mcristaldo17/Single-Axis-Rate-Table/README.md

# Single-Axis Rate Table
## Cloned repository on 03/15/2025
Design and development of a single-axis rate table project for nanosatellites at the "Agencia Espacial del Paraguay" (Paraguay Space Agency).
"Rate Table Codes" includes the codes for the Arduino microcontroller and the codes for the User Interface.
"Anexxes" include detailed documentation.
