mcristaldo17/Single-Axis-Rate-Table/Rate Table Design/Assembly_RateTable.SLDASM

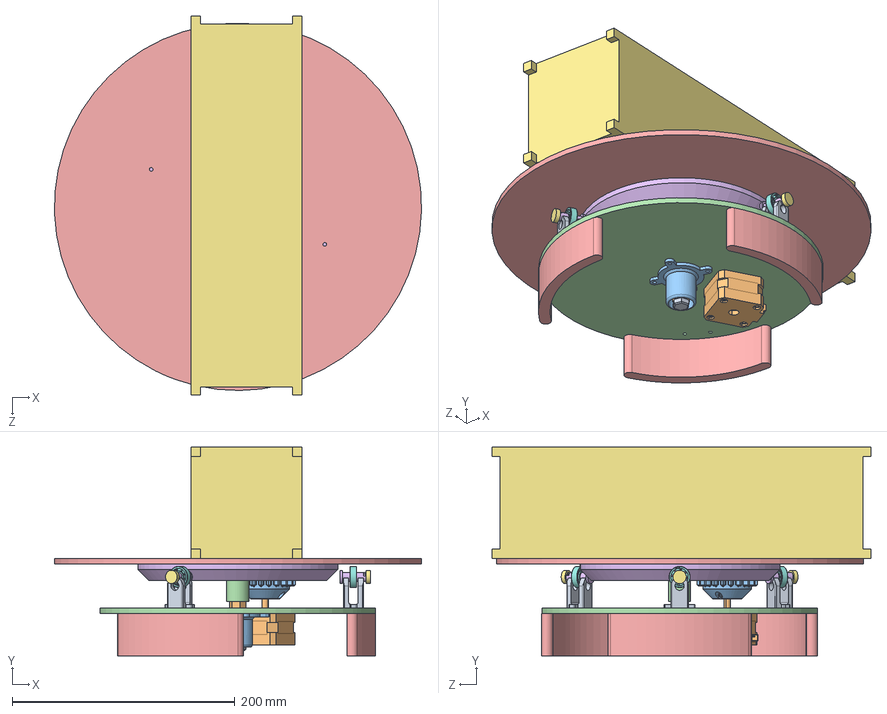
[picture p28: CAD file, 2023-11-02, last stored version]
Rate Table Design/Assembly_RateTable.SLDASM
329.8 x 187.8 x 340.5 mm
Stepper motor Nema 17 (17HS2408).step
Gear_Nema17
Bearing_Support x 3
LaserCut_1
Soportes3D x 3
Pin x 3
Close_Pin x 3
BALL BEARING 607 7x19x6 x 5
M8_Tornillo
M8_Tuerca x 4
Soporte_Central
Centralizador v1
LaserCut_3
External_Gear
