mcristaldo17/Single-Axis-Rate-Table/Rate Table Design/Assembly_Central.SLDASM

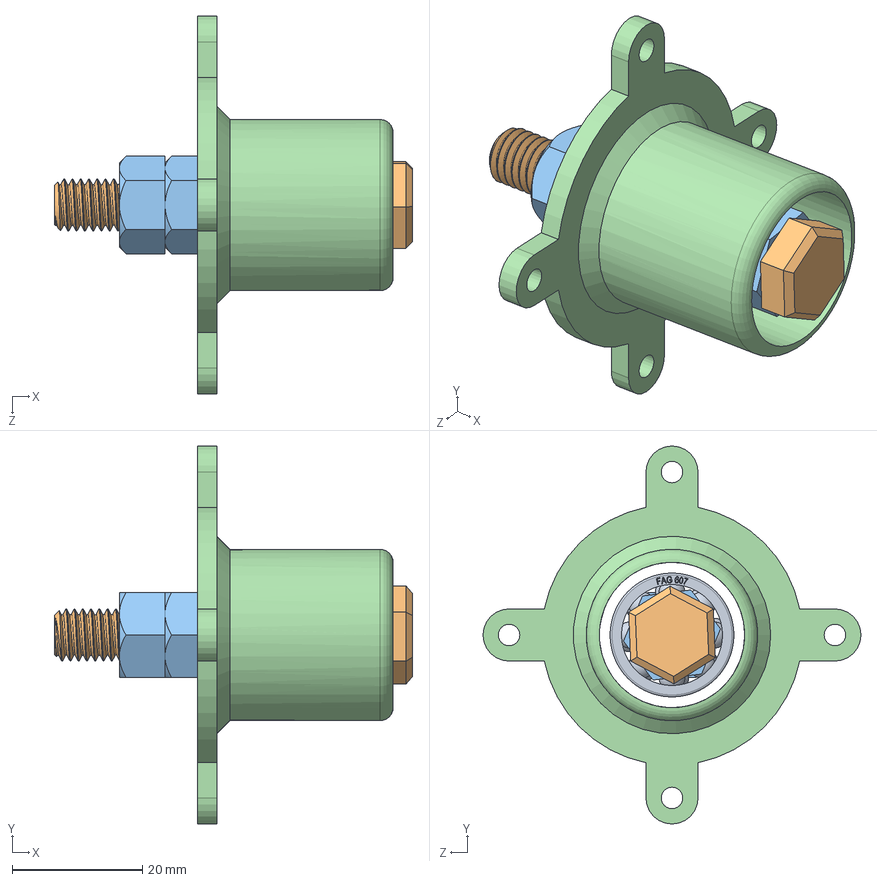
[picture p29: CAD file, 2023-11-02, last stored version]
Rate Table Design/Assembly_Central.SLDASM
55.0 x 58.0 x 58.0 mm
BALL BEARING 607 7x19x6 x 2
M8_Tornillo
M8_Tuerca x 4
Soporte_Central
