mcristaldo17/Single-Axis-Rate-Table/Rate Table Design/Corte Láser/LaserCut_3.SLDPRT

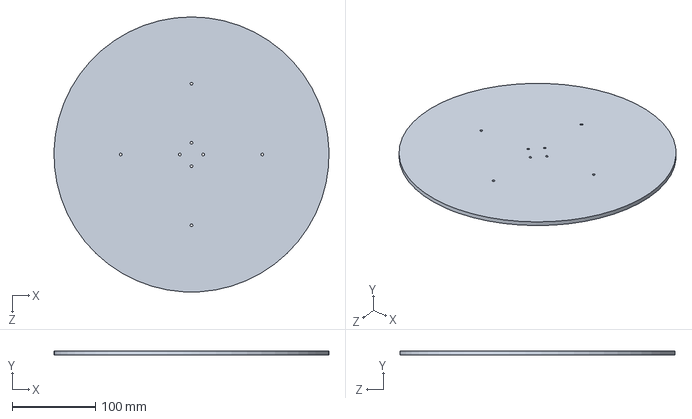
[picture p30: CAD file, 2023-11-02, last stored version]
Rate Table Design/Corte Láser/LaserCut_3.SLDPRT
329.9 x 5.00 x 330.0 mm
