mcristaldo17/Single-Axis-Rate-Table/Rate Table Design/Impresión 3D/Soporte_Central.SLDPRT

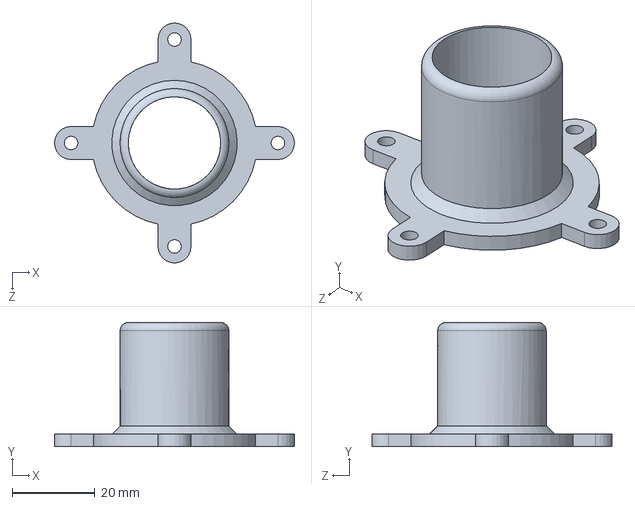
[picture p31: CAD file, 2023-11-02, last stored version]
Rate Table Design/Impresión 3D/Soporte_Central.SLDPRT
58.0 x 30.0 x 58.0 mm
