mcristaldo17/Single-Axis-Rate-Table/Rate Table Design/3U_CubeSat_Dimensions.SLDPRT

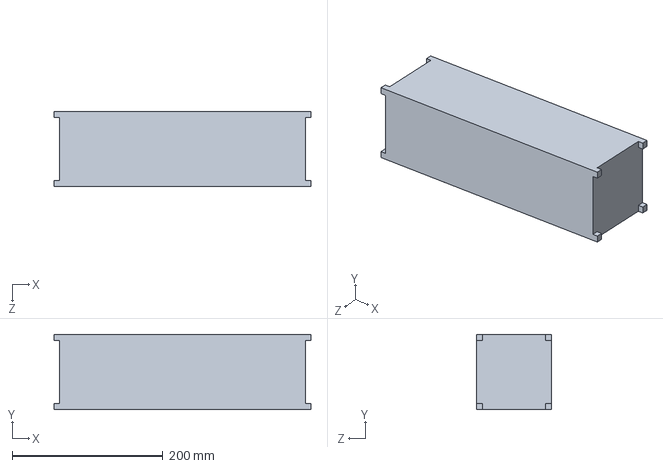
[picture p32: CAD file, 2023-11-02, last stored version]
Rate Table Design/3U_CubeSat_Dimensions.SLDPRT
340.5 x 100.0 x 100.0 mm
