mcristaldo17/Single-Axis-Rate-Table/Rate Table Design/Corte Láser/LaserCut_1.SLDPRT

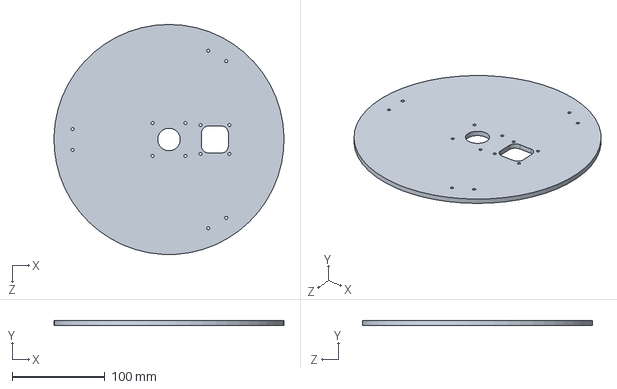
[picture p33: CAD file, 2023-11-02, last stored version]
Rate Table Design/Corte Láser/LaserCut_1.SLDPRT
247.9 x 5.00 x 248.0 mm
