mcristaldo17/Single-Axis-Rate-Table/Rate Table Design/Impresión 3D/Gear_Nema17.SLDPRT

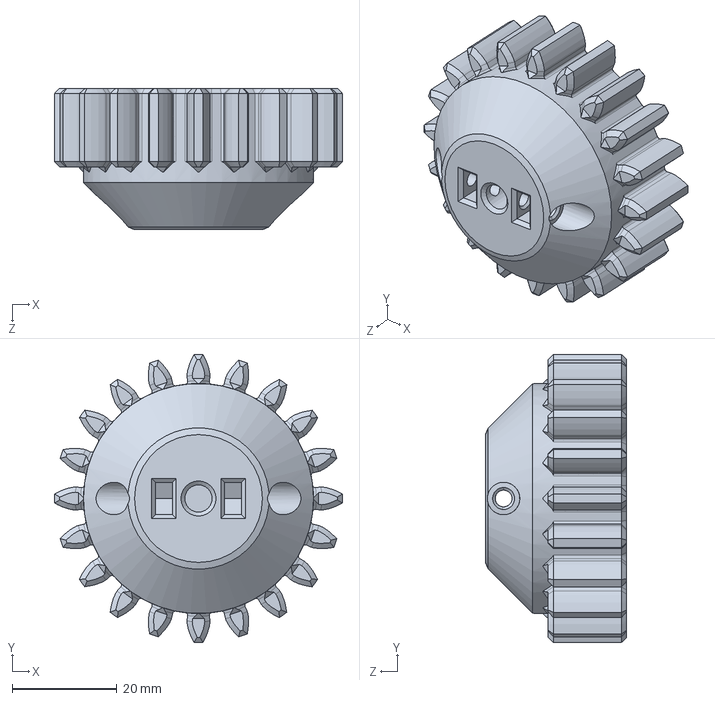
[picture p34: CAD file, 2023-11-02, last stored version]
Rate Table Design/Impresión 3D/Gear_Nema17.SLDPRT
55.0 x 55.0 x 27.0 mm
