mcristaldo17/Single-Axis-Rate-Table/Rate Table Design/Impresión 3D/Soportes3D.SLDPRT

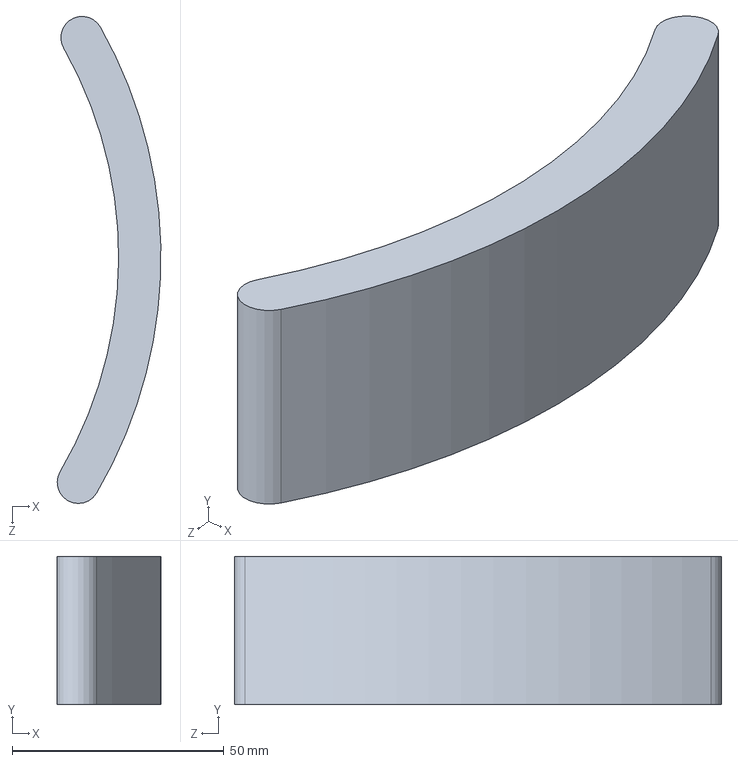
[picture p35: CAD file, 2023-11-02, last stored version]
Rate Table Design/Impresión 3D/Soportes3D.SLDPRT
24.5 x 35.0 x 115.0 mm
