mcristaldo17/Single-Axis-Rate-Table/Rate Table Design/Stepper motor Nema 17 (17HS2408).step.SLDPRT

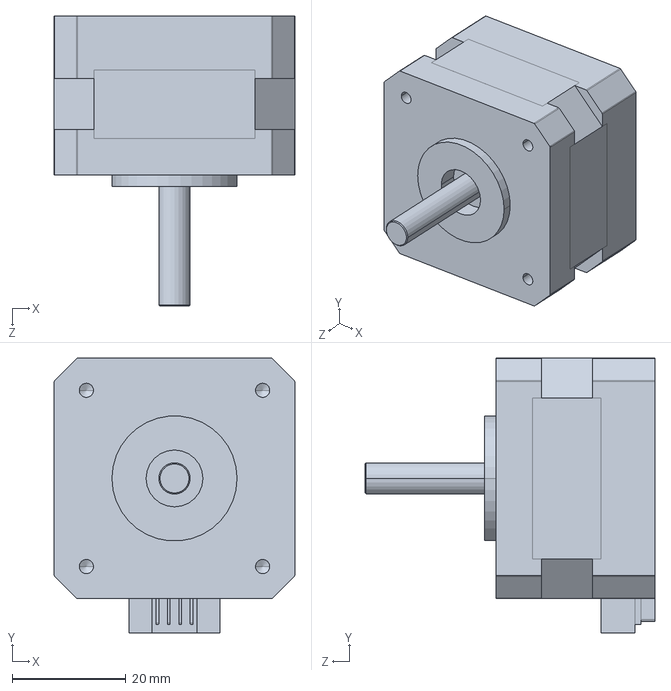
[picture p36: CAD file, 2023-11-02, last stored version]
Rate Table Design/Stepper motor Nema 17 (17HS2408).step.SLDPRT
42.3 x 48.3 x 51.0 mm
