mcristaldo17/Single-Axis-Rate-Table/Rate Table Design/Impresión 3D/Close_Pin.SLDPRT

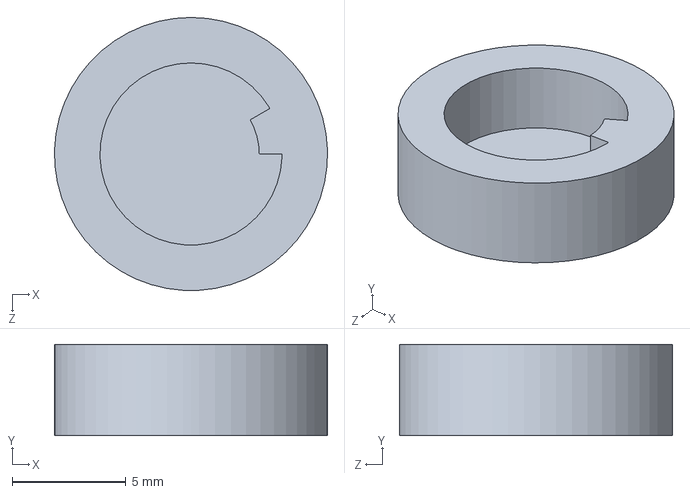
[picture p37: CAD file, 2023-11-02, last stored version]
Rate Table Design/Impresión 3D/Close_Pin.SLDPRT
12.0 x 4.00 x 12.0 mm
