mcristaldo17/Single-Axis-Rate-Table/Rate Table Design/BALL BEARING 607  7x19x6.SLDPRT

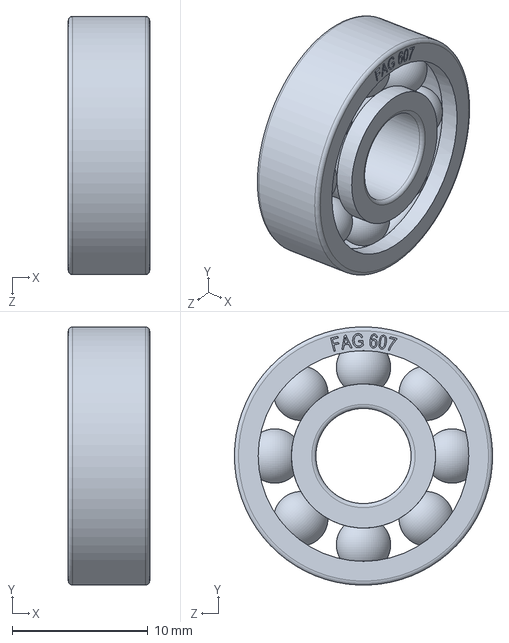
[picture p38: CAD file, 2023-11-02, last stored version]
Rate Table Design/BALL BEARING 607 7x19x6.SLDPRT
6.00 x 19.0 x 19.0 mm
