mcristaldo17/Single-Axis-Rate-Table/Rate Table Design/Impresión 3D/Bearing_Support.SLDPRT

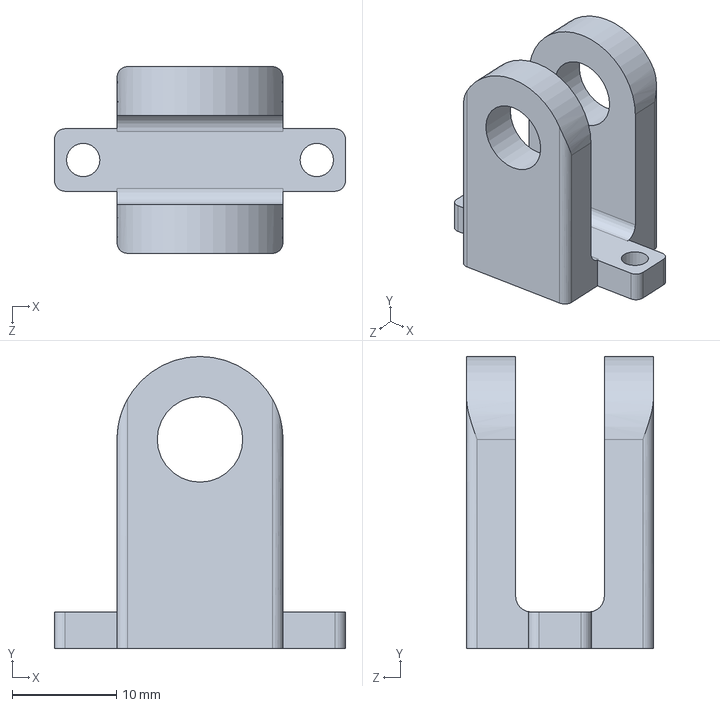
[picture p39: CAD file, 2023-11-02, last stored version]
Rate Table Design/Impresión 3D/Bearing_Support.SLDPRT
27.9 x 28.0 x 17.9 mm
