mcristaldo17/Single-Axis-Rate-Table/Rate Table Design/M8_Tornillo.SLDPRT

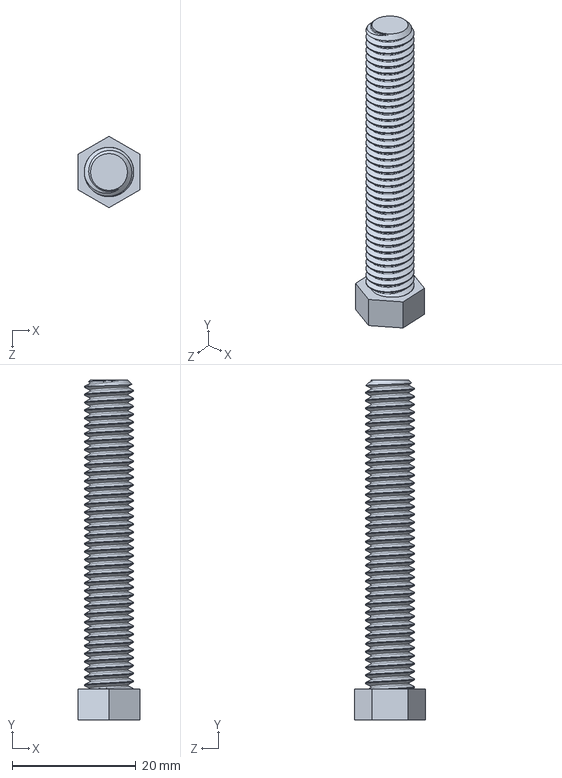
[picture p40: CAD file, 2023-11-02, last stored version]
Rate Table Design/M8_Tornillo.SLDPRT
10.0 x 55.0 x 11.5 mm
