mcristaldo17/Single-Axis-Rate-Table/Rate Table Design/Impresión 3D/External_Gear.SLDPRT

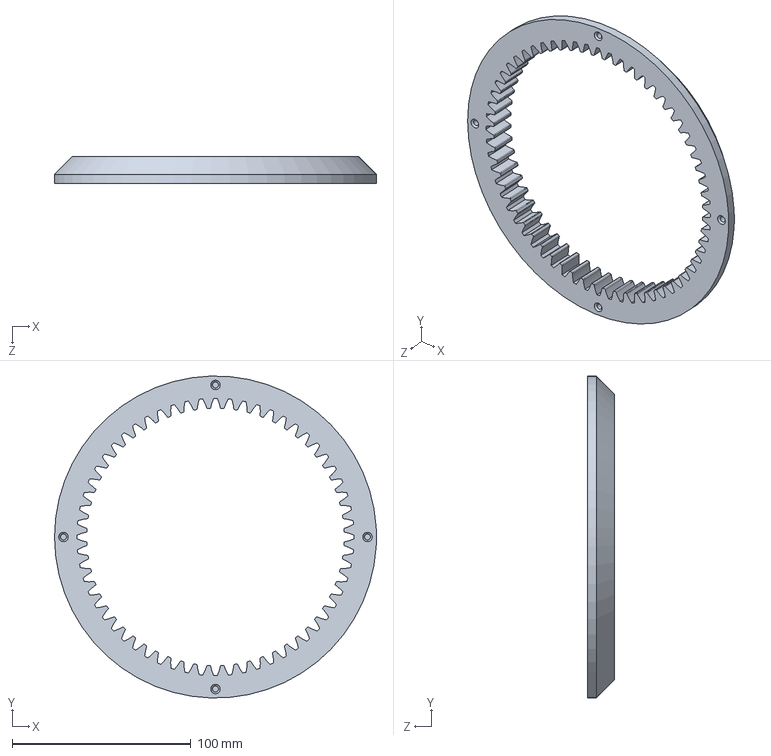
[picture p41: CAD file, 2023-11-02, last stored version]
Rate Table Design/Impresión 3D/External_Gear.SLDPRT
180.0 x 179.9 x 15.0 mm
