mcristaldo17/Single-Axis-Rate-Table/Rate Table Design/M8_Tuerca.SLDPRT

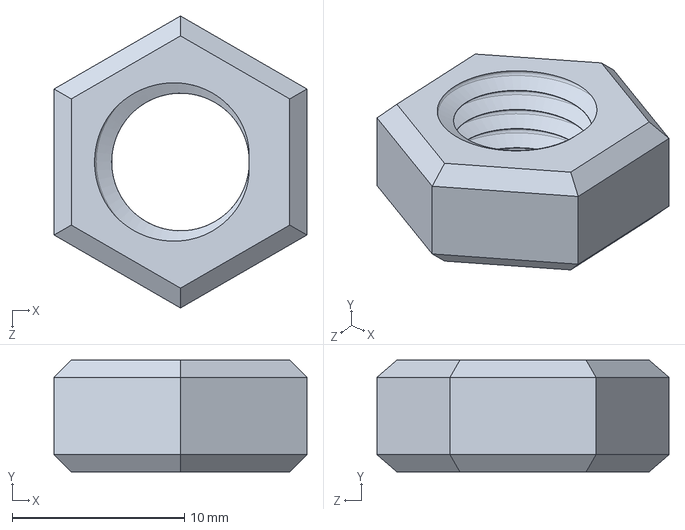
[picture p42: CAD file, 2023-11-02, last stored version]
Rate Table Design/M8_Tuerca.SLDPRT
14.7 x 6.50 x 17.0 mm
