mcristaldo17/Single-Axis-Rate-Table/Rate Table Design/Impresión 3D/Centralizador v1.SLDPRT

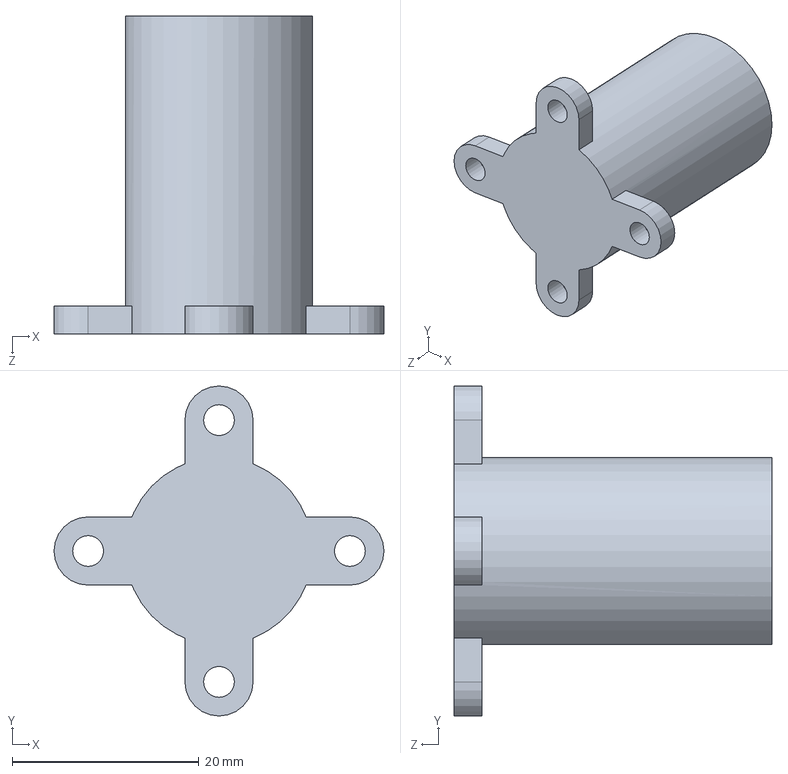
[picture p43: CAD file, 2023-11-02, last stored version]
Rate Table Design/Impresión 3D/Centralizador v1.SLDPRT
35.3 x 35.3 x 34.0 mm
