mcristaldo17/Single-Axis-Rate-Table/Rate Table Design/Impresión 3D/Pin.SLDPRT

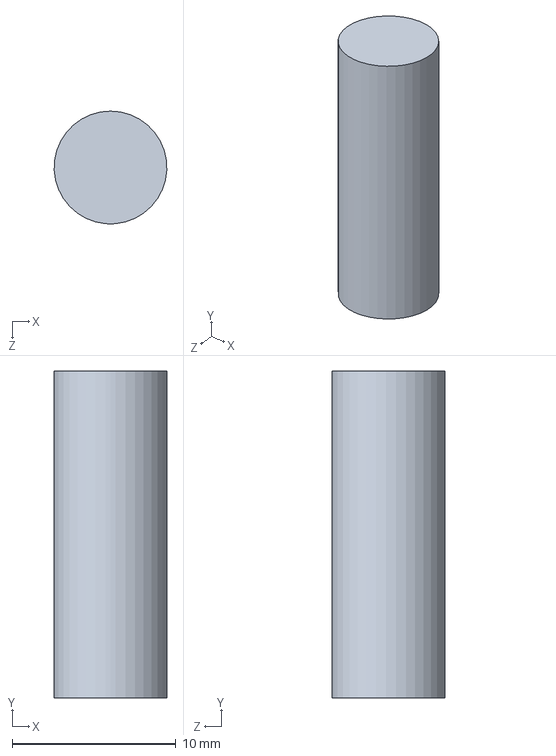
[picture p44: CAD file, 2023-11-02, last stored version]
Rate Table Design/Impresión 3D/Pin.SLDPRT
6.89 x 20.0 x 6.90 mm
