mcristaldo17/Single-Axis-Rate-Table/(list of files, cad)

Other CAD files:
Rate Table Design/Corte Láser/LaserCut_2.SLDPRT
Rate Table Design/Impresión 3D/Eje_Central.SLDPRT
Rate Table Design/Impresión 3D/Centralizador.STL
Rate Table Design/Corte Láser/LaserCut_1.DWG
Rate Table Design/Corte Láser/LaserCut_2.DWG
Rate Table Design/Corte Láser/LaserCut_3.DWG
Rate Table Design/Impresión 3D/Bearing_Support.STL
Rate Table Design/Impresión 3D/Close_Pin.STL
Rate Table Design/Impresión 3D/Eje_Central.STL
Rate Table Design/Impresión 3D/Pin.STL
